KDaliri/MIDI-controller/Hardware Block Diagram V3 MAIN.pdf

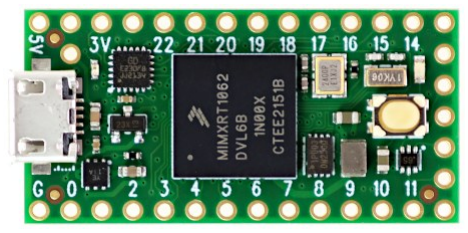
[picture p4: figure]

14 | 15 | 16 | 17 | 18
19 | 20 | 21 | 22 | 23

1

4 | 5 | 6
7 | 24/25/8

CC ON/OFF toggle: 1-6

Right click: 8 | Left click: 7

CC potentiometer: 14-23

Cursor x axis: 24 | Cursor y axis: 25
2 | 3
