KDaliri/MIDI-controller/hardware block diagram.pdf

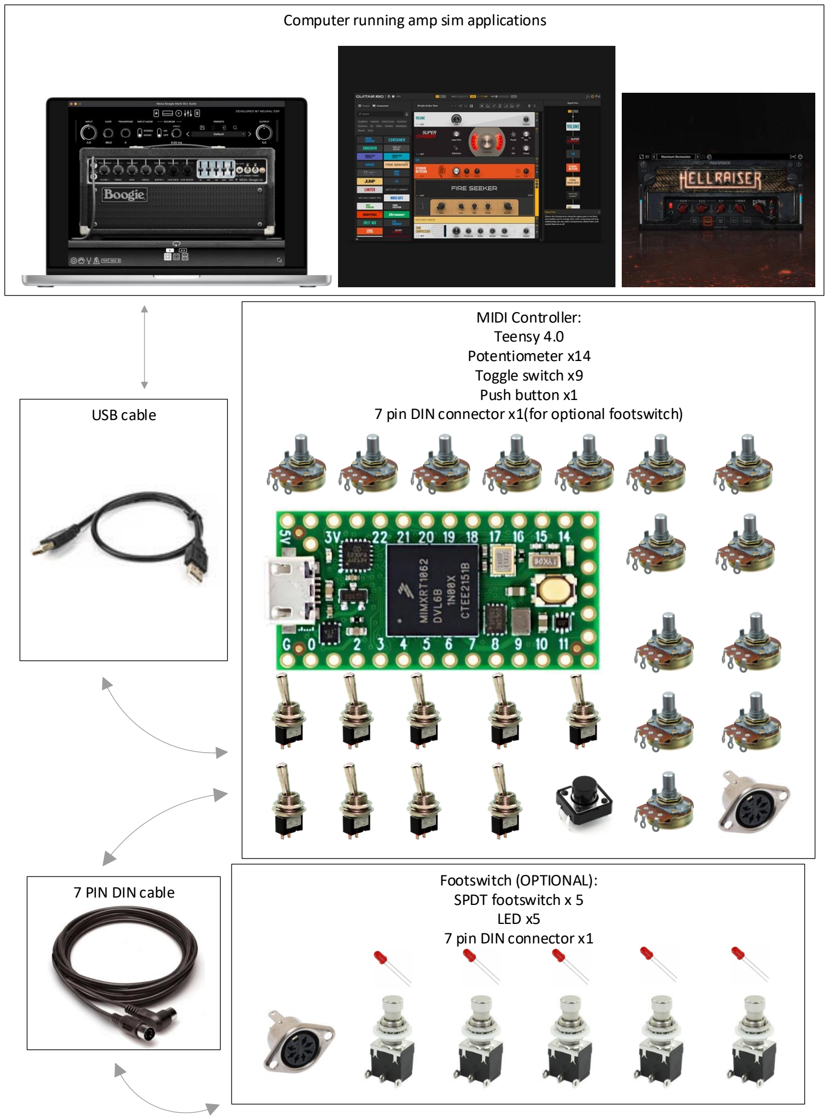
[picture p5: page 1]

MIDI Controller:
Teensy 4.0
Potentiometer x14
Toggle switch x9
Push button x1
7 pin DIN connector x1(for optional footswitch)

Footswitch (OPTIONAL):
SPDT footswitch x 5
LED x5
7 pin DIN connector x1

Computer running amp sim applications

USB cable

7 PIN DIN cable
