KDaliri/MIDI-controller/Pedal Dimensions Top.pdf

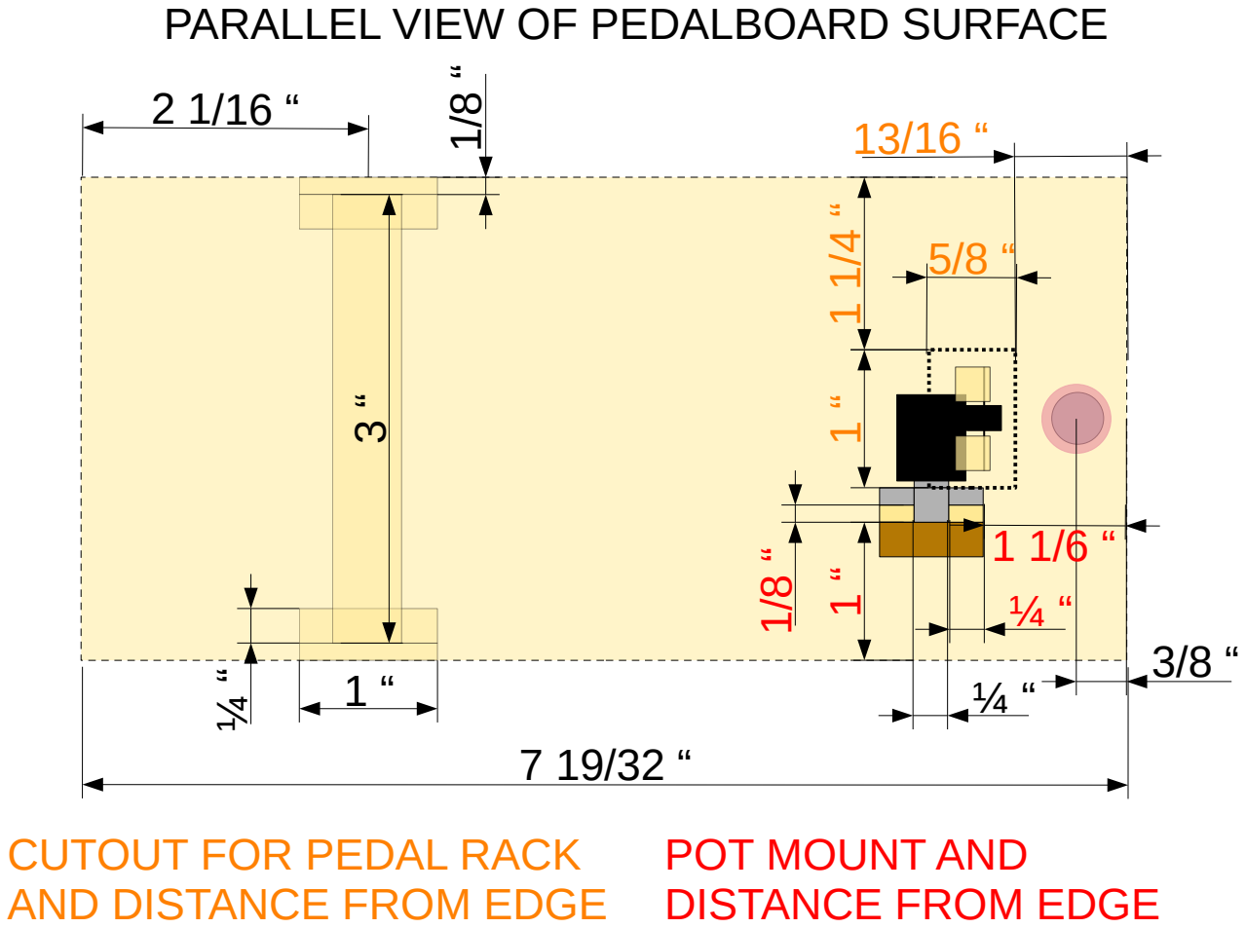
[picture p6: figure]
POT MOUNT AND DISTANCE FROM EDGE; CUTOUT FOR PEDAL RACK AND DISTANCE FROM EDGE; PARALLEL VIEW OF PEDALBOARD SURFACE
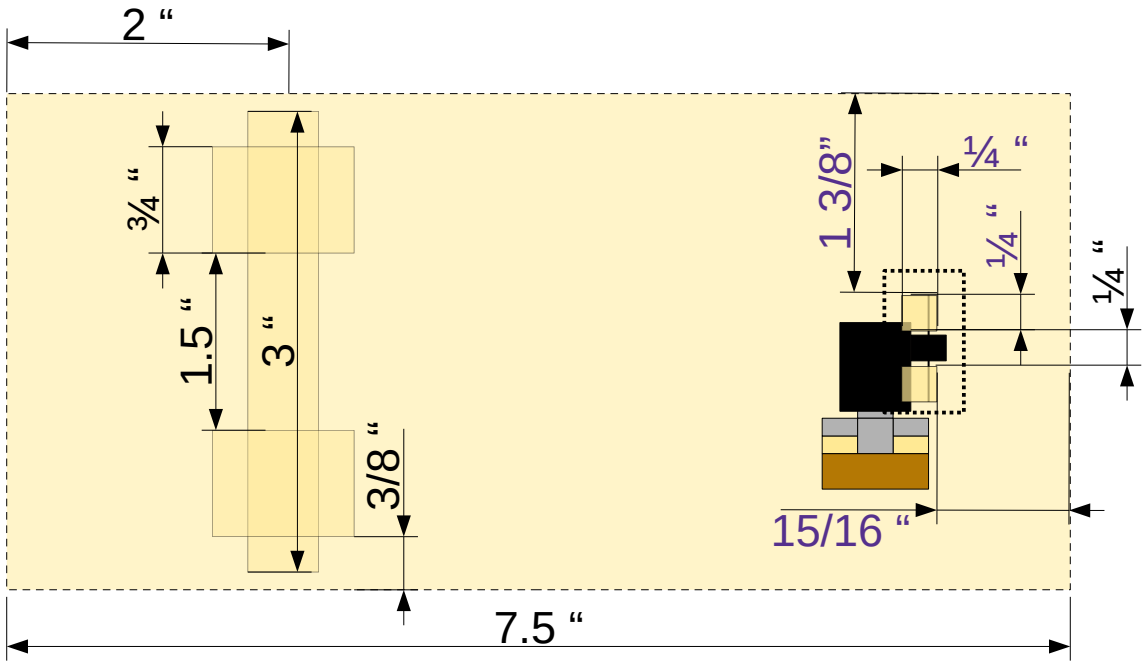
[picture p7: figure]

PEDAL RACK MOUNT AND DISTANCE FROM EDGE

VIEW OF PEDAL PARALLEL TO SURFACE OF GROUND
