KDaliri/MIDI-controller/software block diagram.pdf

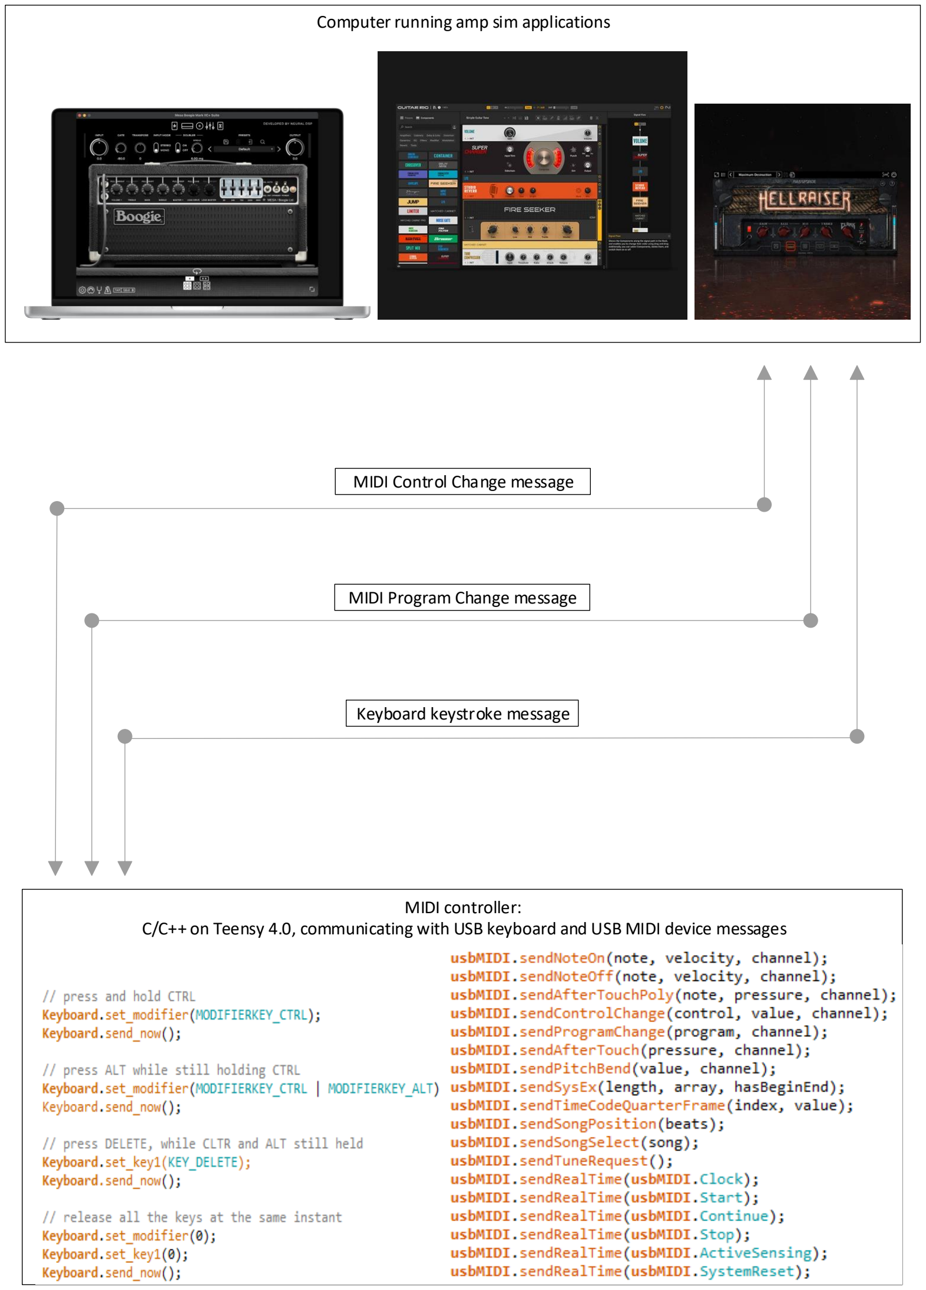
[picture p9: page 1]

MIDI controller:
C/C++ on Teensy 4.0, communicating with USB keyboard and USB MIDI device messages

Computer running amp sim applications

MIDI Control Change message

MIDI Program Change message

Keyboard keystroke message
