KDaliri/MIDI-controller/ContributionToProject.md

Can each team member add to as to what they perceive their contribution to the project will have ultimately be?

Renbert Jabez Jose's potential contribution:
What I feel I’ll be able to contribute to the project is to oversee if certain circumstances will work given our ability to be able to complete certain milestones in the project; things like, 
assembly management and ensuring every little thing is working and inquiring if we need to go back and review it. I find myself more effective when it comes to performing hands-on work like putting the physical components together and overseeing the final product.
Vaibhav Patel's potential contribution
I think i am able to contribute in interfacing sides through coding so basically physical hardware interface with software. I feel i am good at software side so yaa i will give my contribution on software as well as developing ideas towards how physcial midi controler
