KDaliri/MIDI-controller/Hardware Block Diagram V3 FOOTSWITCH.pdf

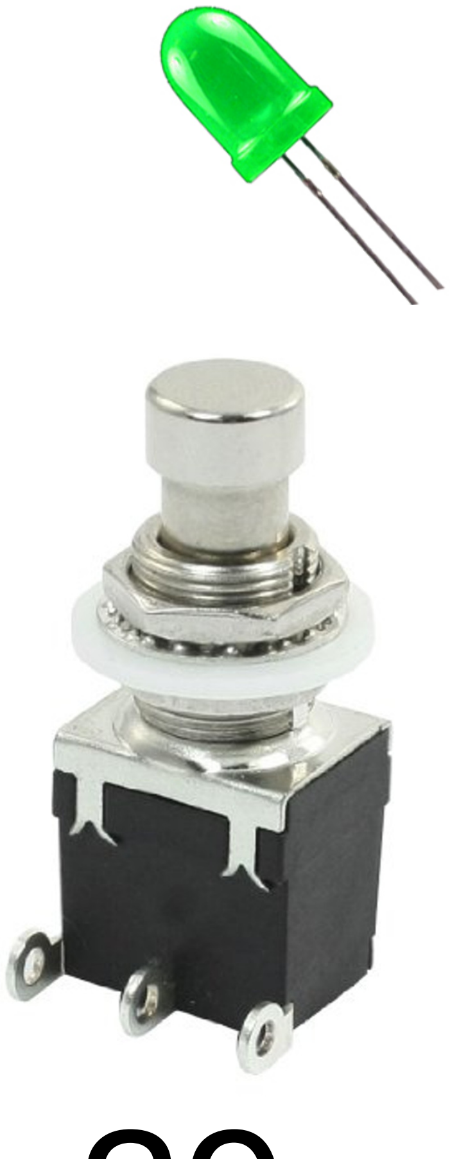
[picture p10: figure]
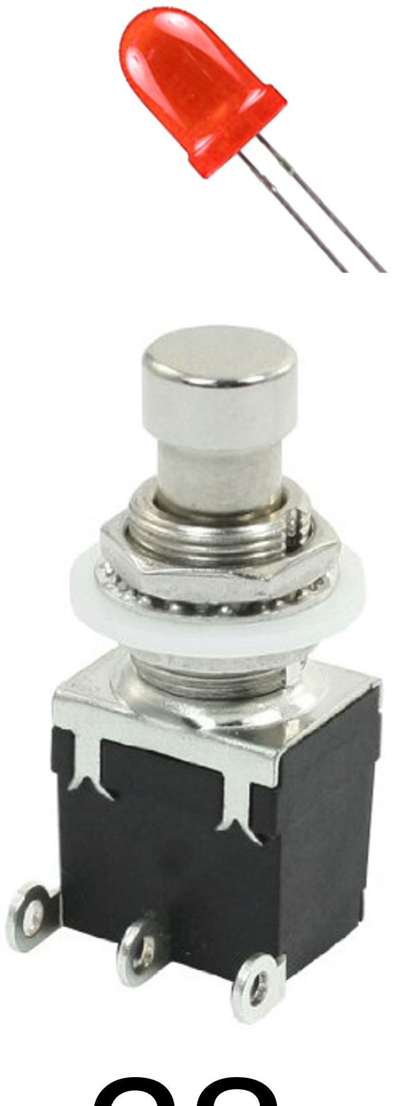
[picture p11: figure]
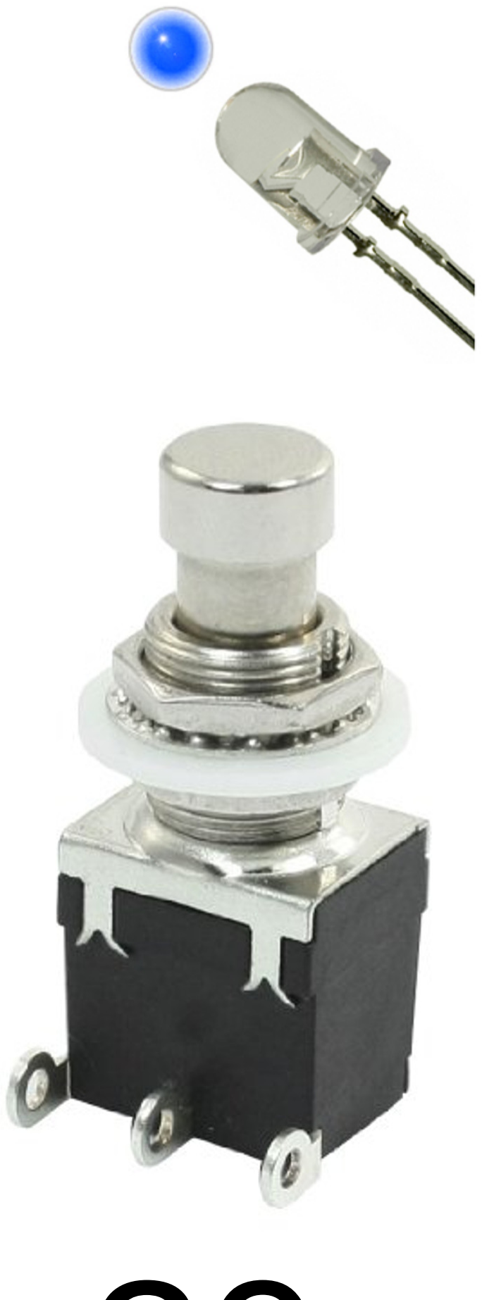
[picture p12: figure]
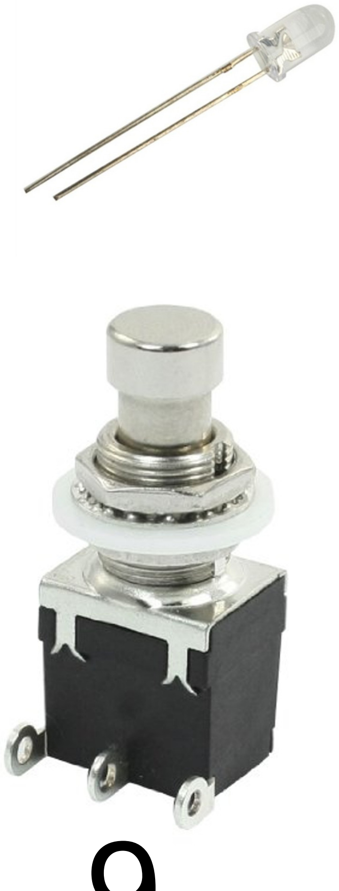
[picture p13: figure]
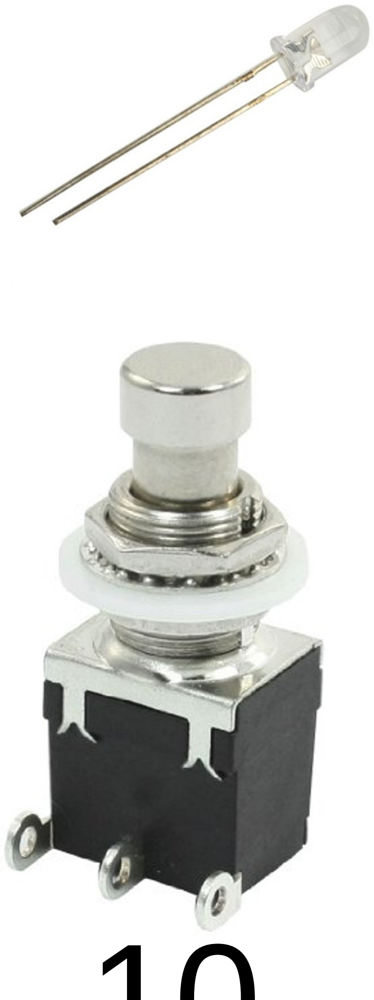
[picture p14: figure]

28 | 29 | 30

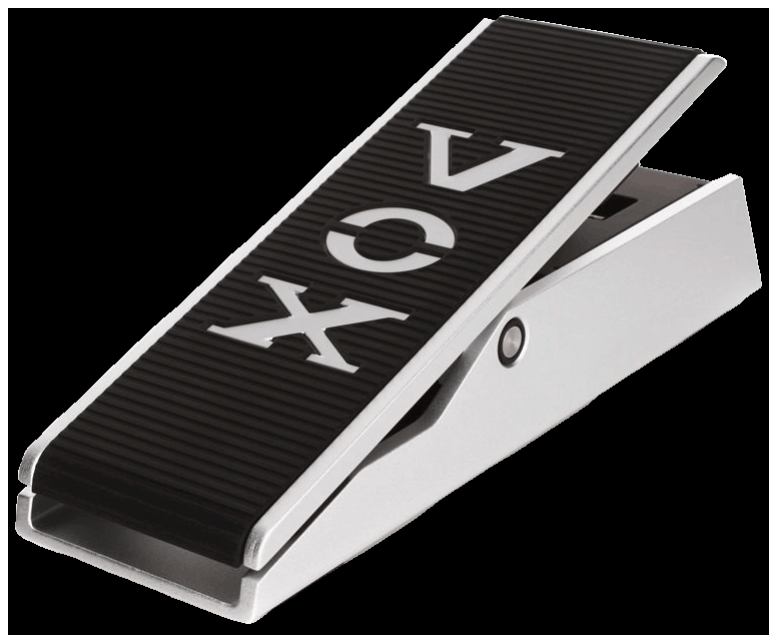
[picture p15: figure]

26 | 27
9 | 10

Programmable footswitch: 28-33

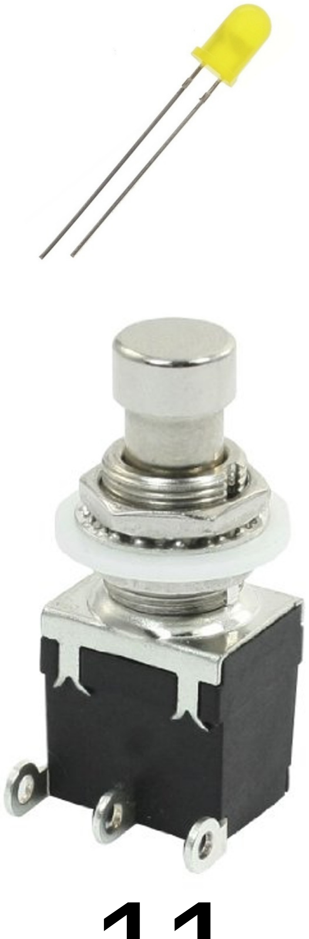
[picture p16: figure]
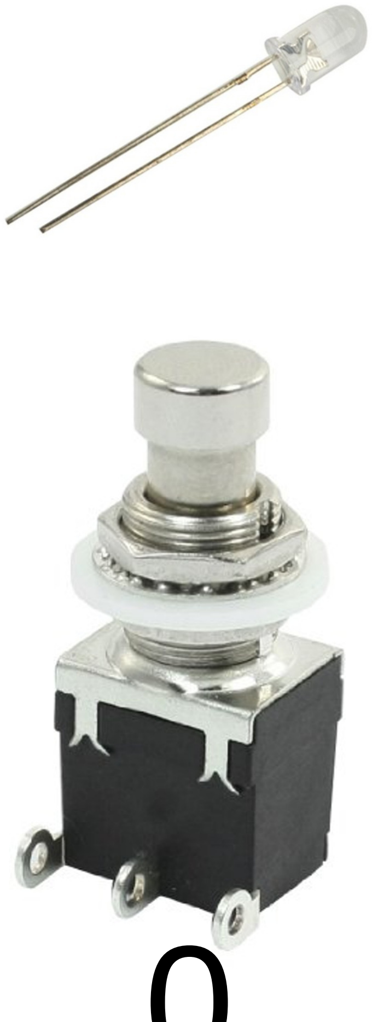
[picture p17: figure]
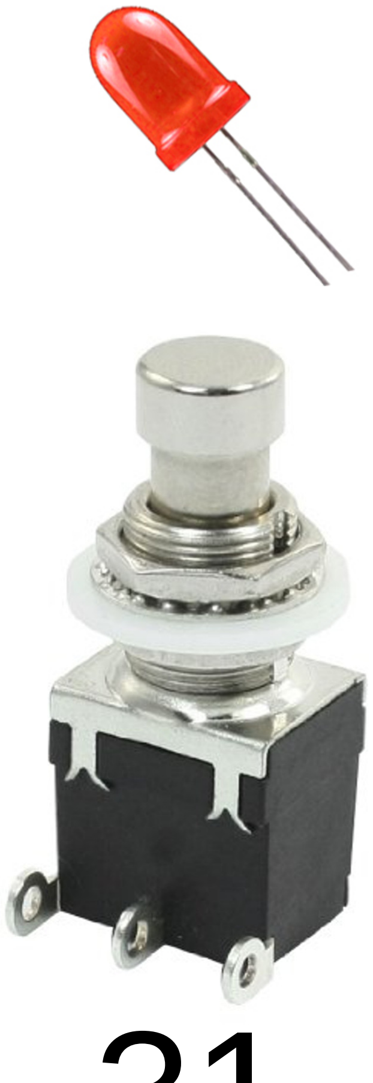
[picture p18: figure]
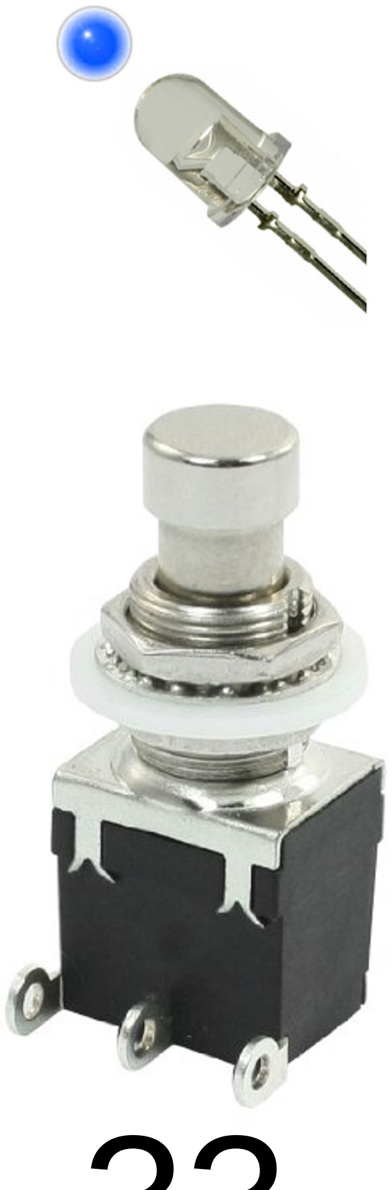
[picture p19: figure]
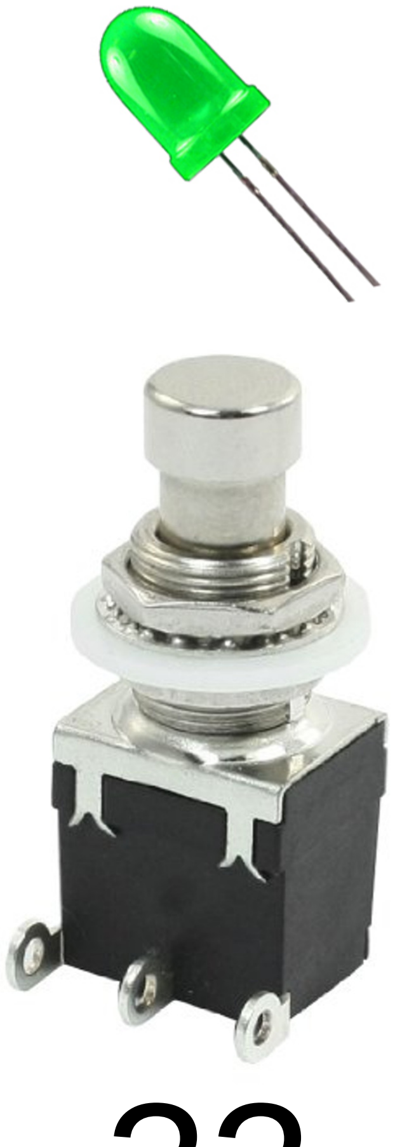
[picture p20: figure]

Expression pedal: 26, 27 | Expression ON/OFF latched footswitch: 9, 10
31 | 32 | 33 | 0
11 | 12
Bank select: 0 | Program default CC/PC select: 12

Programming mode: 11
