KDaliri/MIDI-controller/Head Dimensions side.pdf

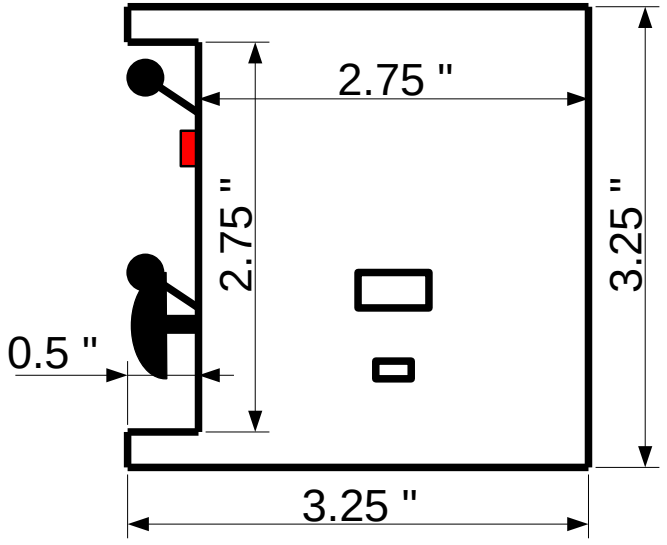
[picture p21: figure]
