KDaliri/MIDI-controller/Footswitch Dimensions side.pdf

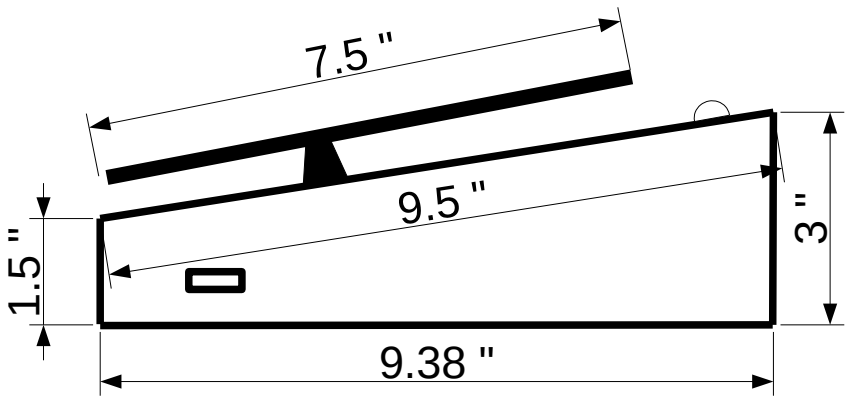
[picture p22: figure]
