KDaliri/MIDI-controller/Hardware Block Diagram V2 MAIN.pdf

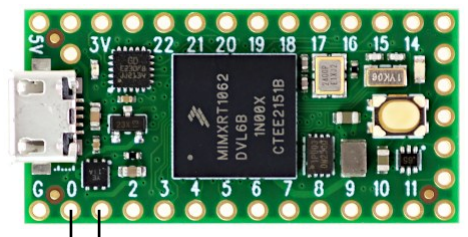
[picture p23: figure]

14 | 15 | 16 | 17 | 18
19 | 20 | 21 | 22 | 23

3

7 | 8 | 9 | 10
12 | 24/25/11

Footswitch programming mode: 2

CC ON/OFF toggle: 3-10

Right click: 11 Left click: 12

CC potentiometer: 14-23

Cursor x axis: 24 | Cursor y axis: 25

2

4 | 5 | 6

Serial MIDI feedback loop: 0-1
