KDaliri/MIDI-controller/Hardware Block Diagram V2 FOOTSWITCH.pdf

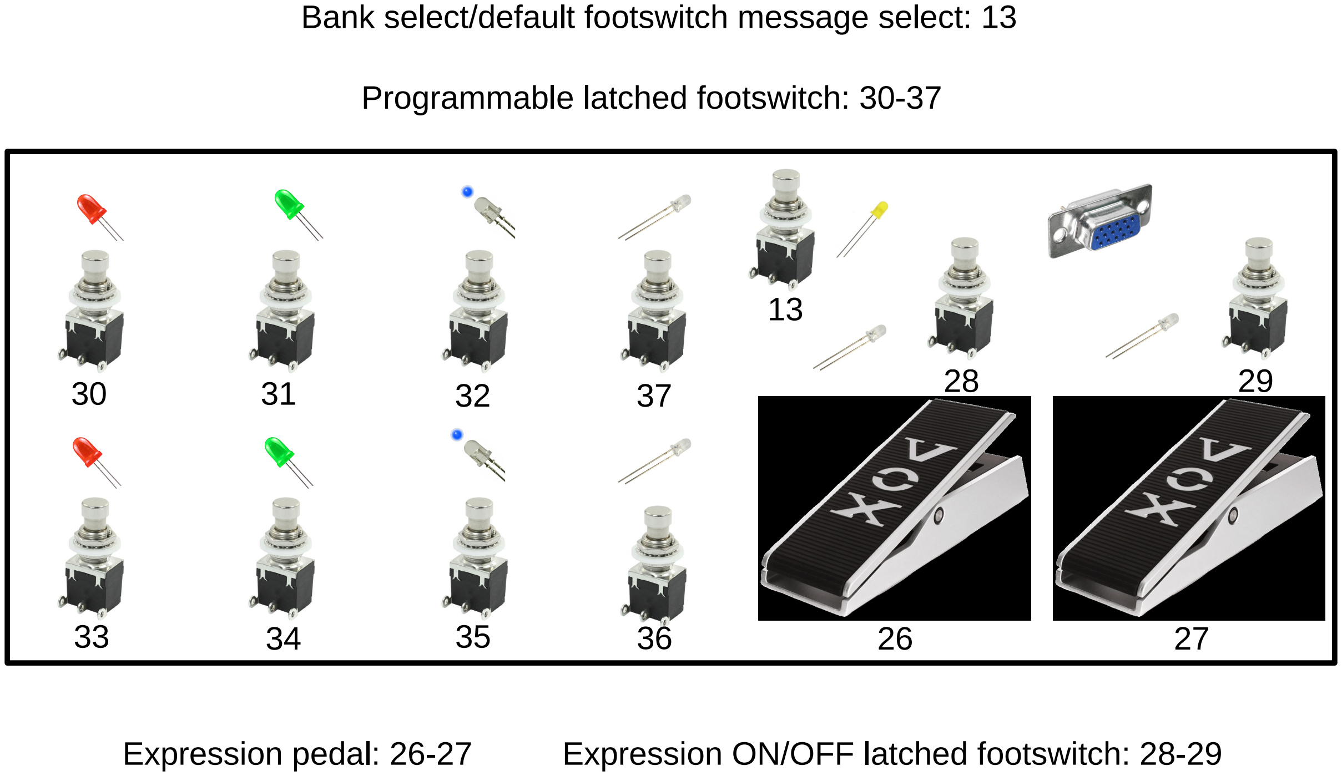
[picture p24: page 1]

30 | 31 | 32
26 | 27
28 | 29

Programmable latched footswitch: 30-37

Expression pedal: 26-27 | Expression ON/OFF latched footswitch: 28-29
33 | 34 | 35 | 36
| | | 37

13

Bank select/default footswitch message select: 13
