KDaliri/MIDI-controller/Pedal Dimensions Side.pdf

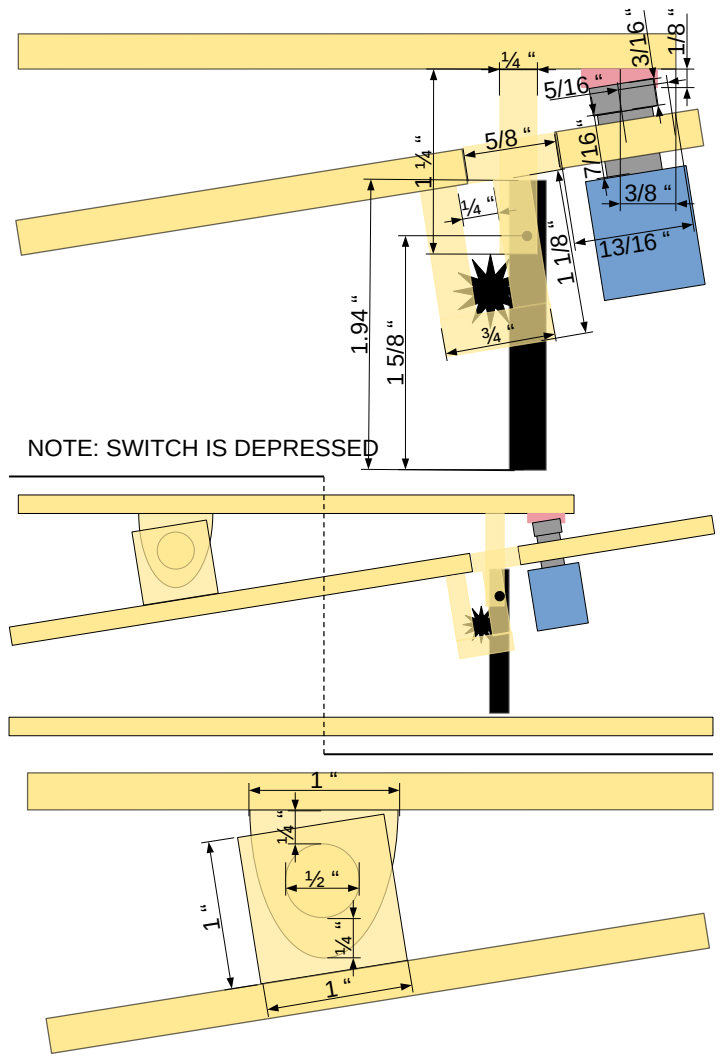
[picture p25: page 1]

NOTE: SWITCH IS DEPRESSED
