KDaliri/MIDI-controller/Head Dimensions front.pdf

3.25 ʺ

## joystick mounting holes

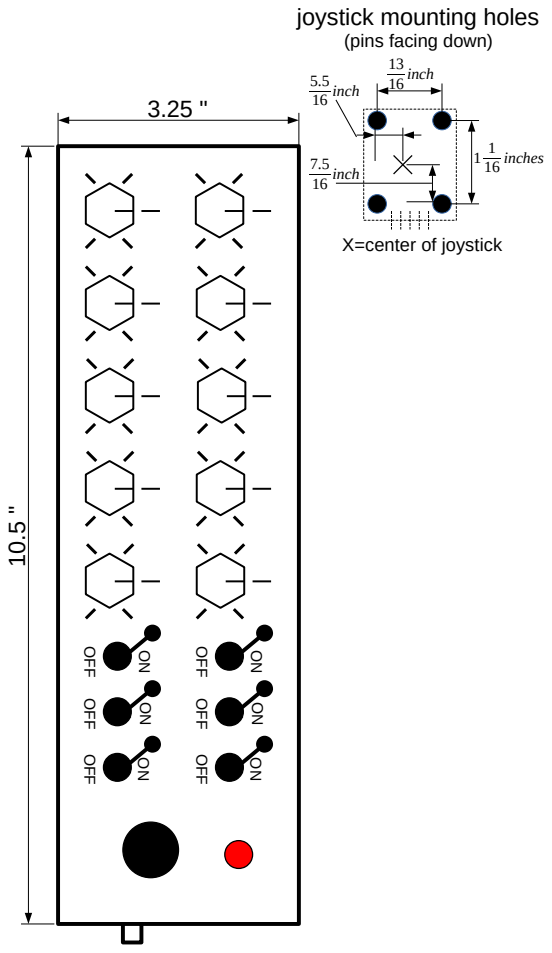
[picture p26: page 1]
1 16 inches; 13 16 inch; 5.5 16 inch; 7.5 16 inch; (pins facing down)

X=center of joystick
