KDaliri/MIDI-controller/MIDI_CONTROLLER_WBS.pdf

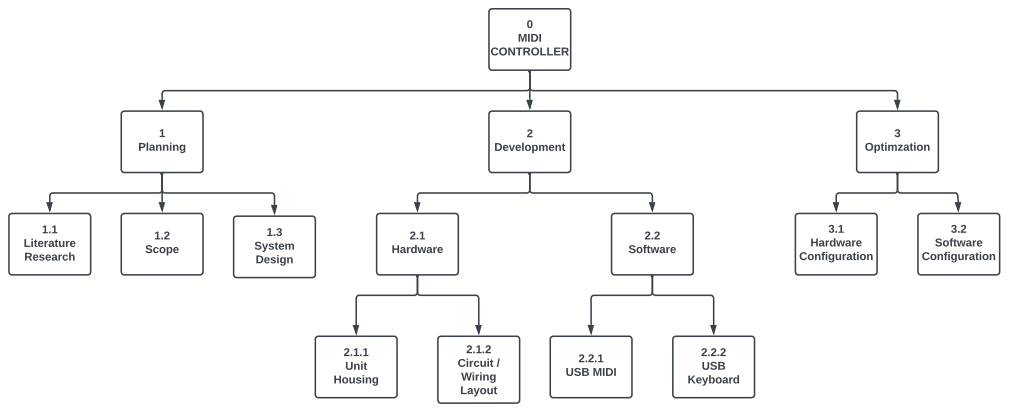
[picture p27: page 1]
0 MIDI CONTROLLER; 1 Planning; 1.2 Scope; 1.3 System Design; 1.1 Literature Research; 3 Optimzation; 2 Development; 2.1 Hardware; 2.2 Software; 2.2.1 USB MIDI; 2.2.2 USB Keyboard; 2.1.1 Unit Housing; 2.1.2 Circuit / Wiring Layout; 3.1 Hardware Configuration; 3.2 Software Configuration
