KDaliri/MIDI-controller/Footswitch Dimensions top.pdf

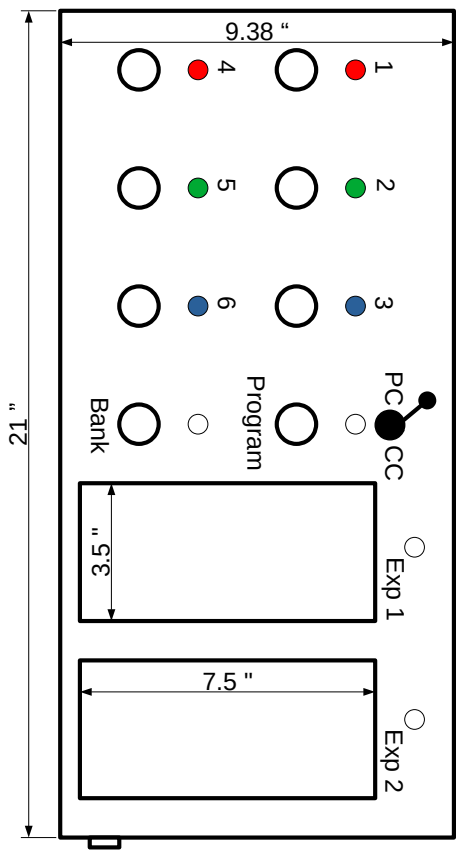
[picture p28: page 1]
Bank; Program

PC CC Exp 1 Exp 2
