KDaliri/MIDI-controller/(commit log)

2024-02-14 Add files via upload
    boards.txt -> C:\Users\asus\AppData\Local\Arduino15\packages\teensy\hardware\avr\1.58.2
    usb_desc.c, usb_desc.h -> C:\Users\asus\AppData\Local\Arduino15\packages\teensy\hardware\avr\1.58.2\cores\teensy4
    delete: C:\Users\asus\AppData\Roaming\Arduino IDE and C:\Users\asus\AppData\Roaming\arduino-ide, then open Arduino IDE
2024-02-29 Update usb_desc.h
    modified usb_desc.h of teensyduino version 1.59 to accommodate MIDI + MOUSE + KEYBOARD
2024-02-29 Update boards.txt
    Updated boards.txt for teensyduino version 1.59 to accommodate MIDI + MOUSE + KEYBOARD for Teensy 4.0 and Teensy 4.1
2024-03-03 Update MIDI_CONTROLLER_PROJ_V5.ino
    Program mode is still unstable
    [MIDI_CONTROLLER_PROJ_V5.ino]
